irekuervo/c2/Imagenes finales/Mati kpo forever on the moon/corriente drain.png

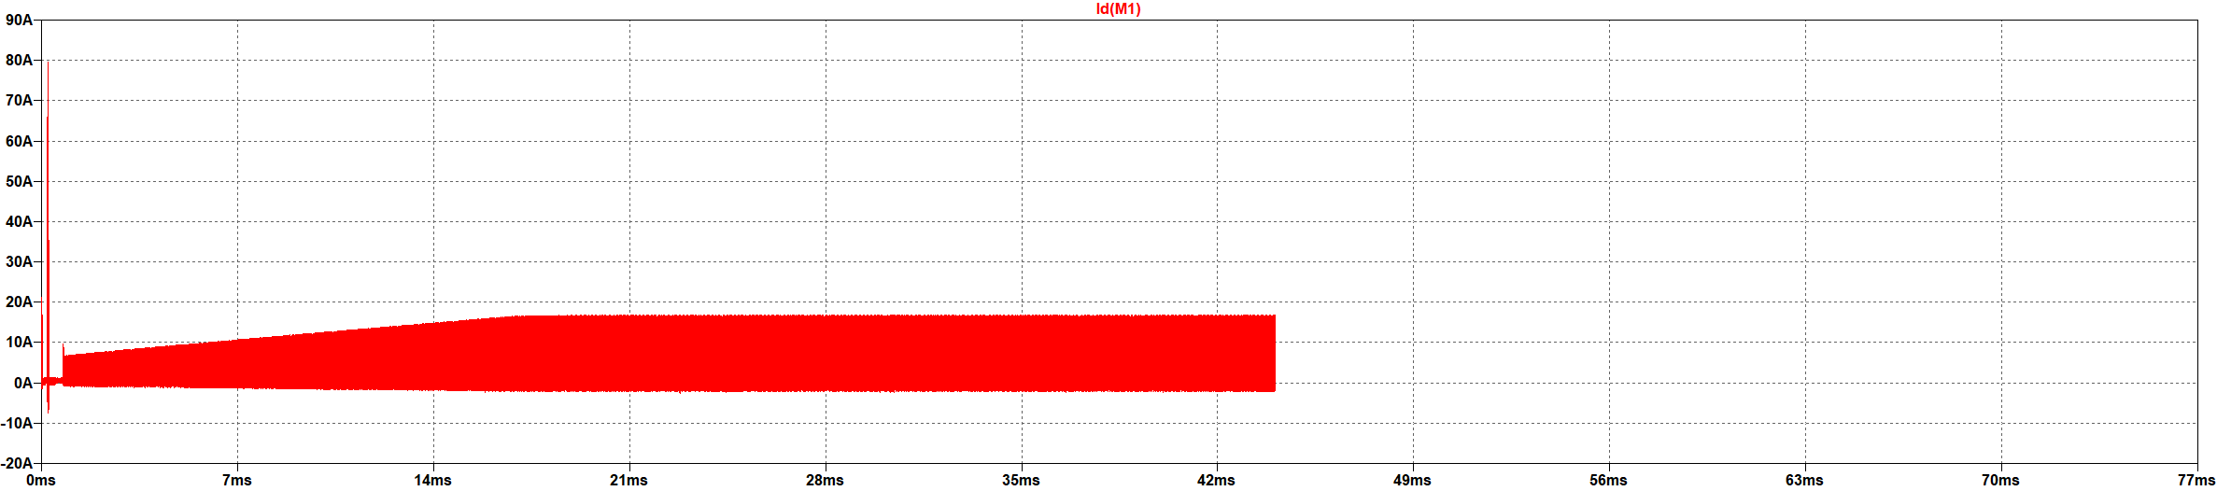
Imagenes finales/Mati kpo forever on the moon/corriente drain.png
