irekuervo/c2/Imagenes finales/Mati kpo forever on the moon/corriente y tension de drain.png

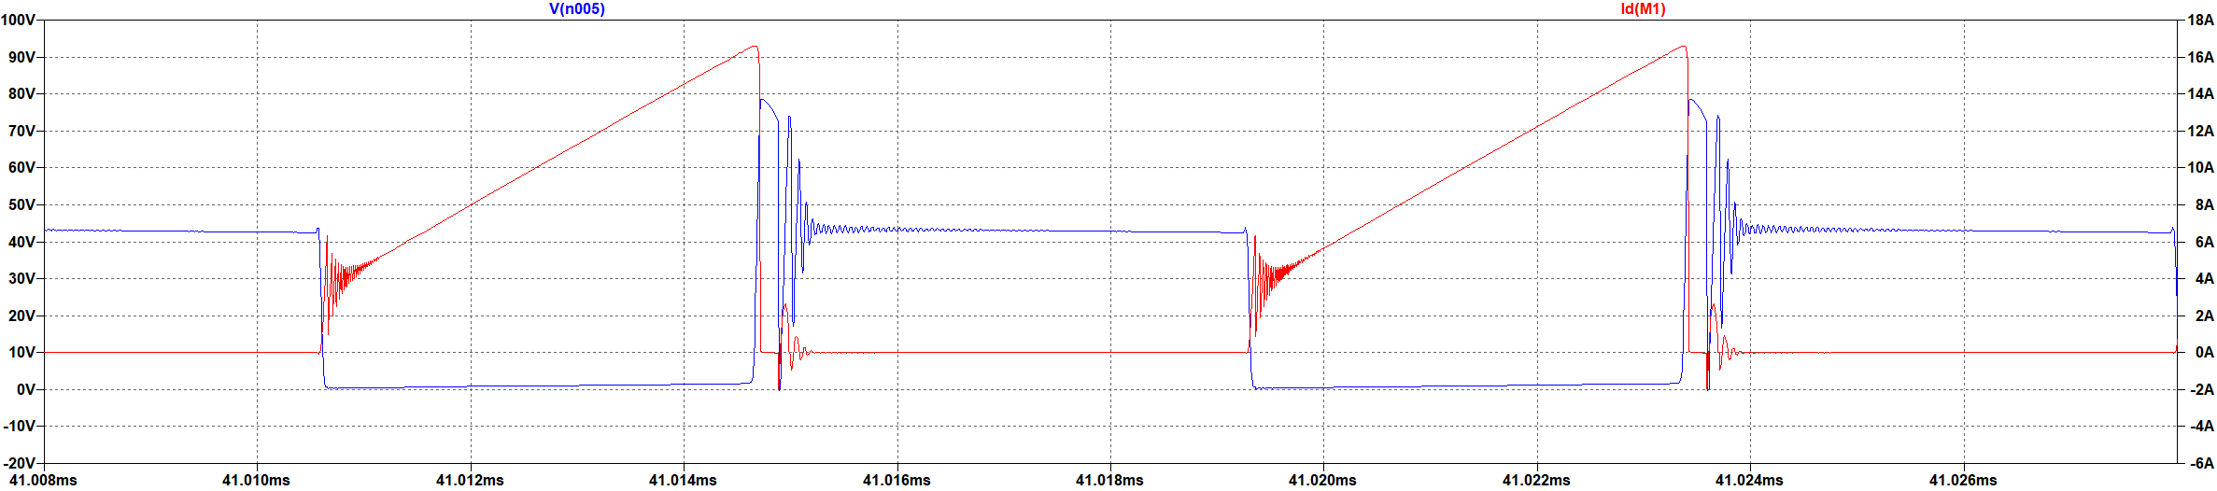
Imagenes finales/Mati kpo forever on the moon/corriente y tension de drain.png
