irekuervo/c2/Imagenes finales/Mati kpo forever on the moon/fuente con driver.png

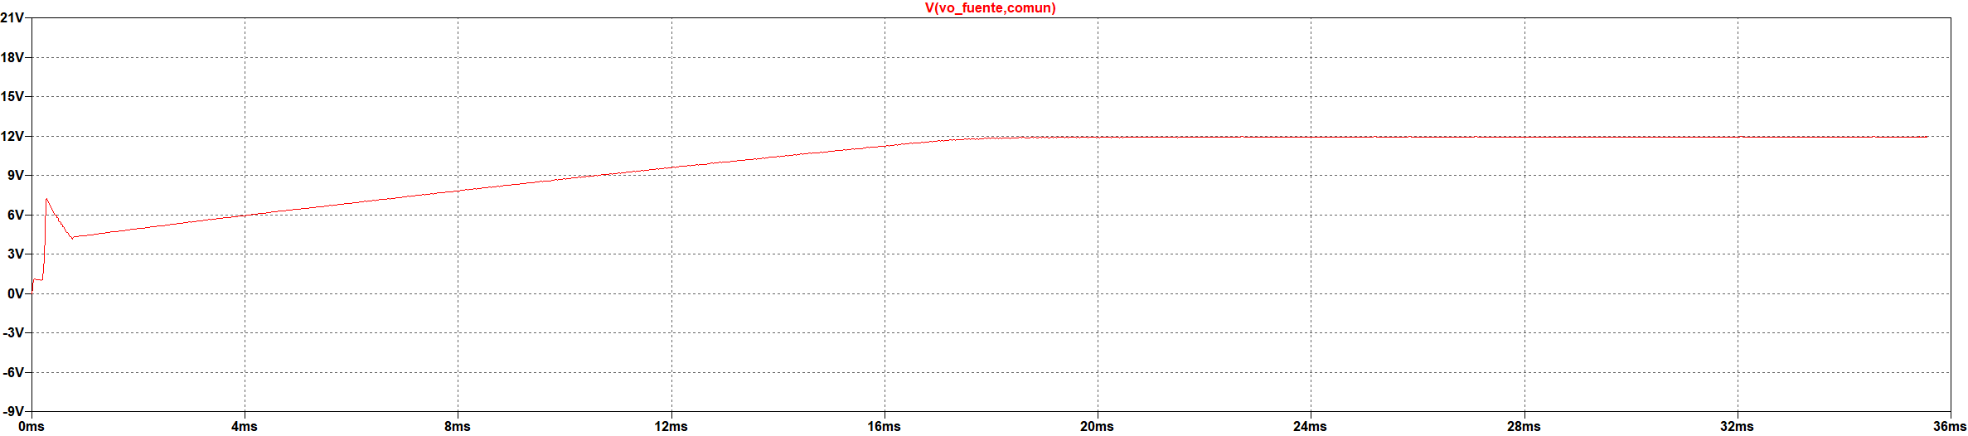
Imagenes finales/Mati kpo forever on the moon/fuente con driver.png
