irekuervo/c2/Imagenes finales/Mati kpo forever on the moon/fuente y control.png

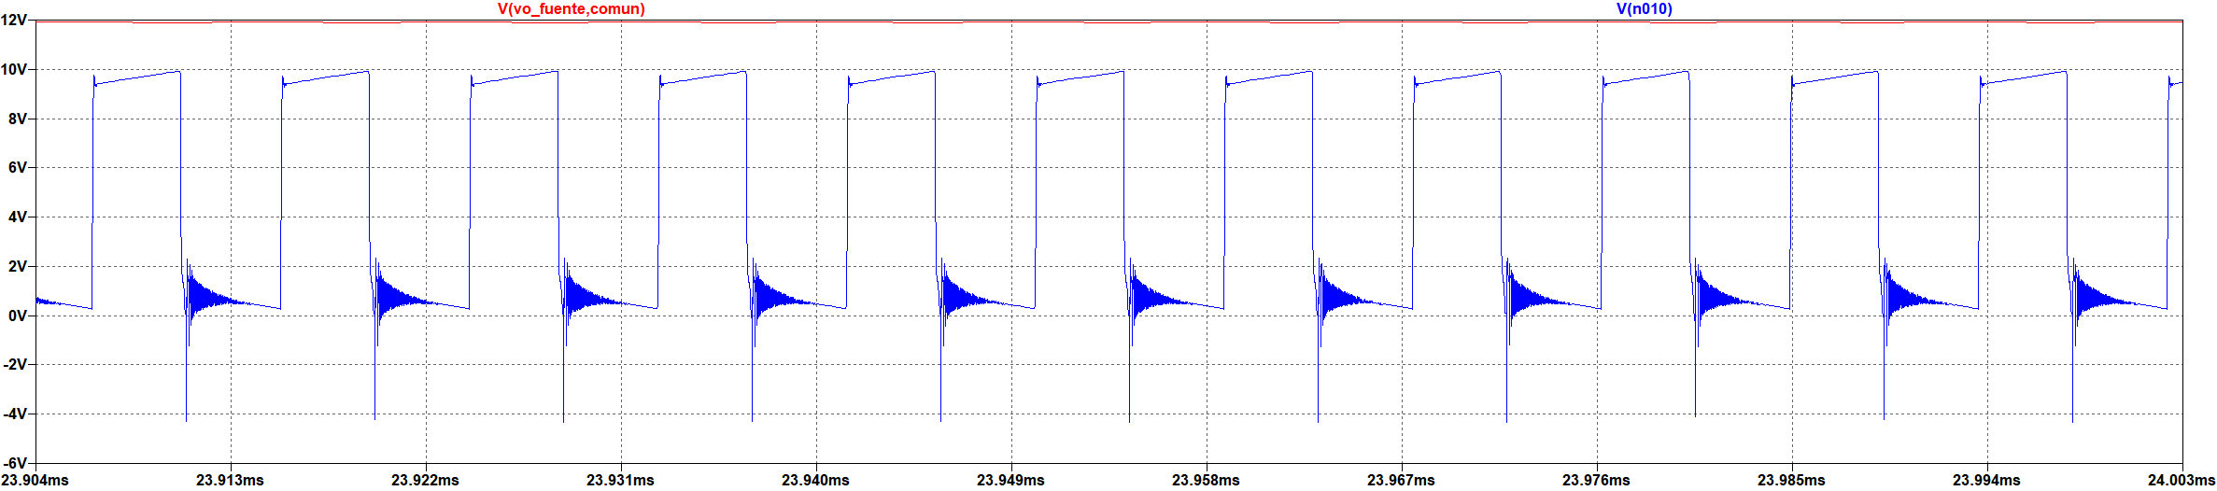
Imagenes finales/Mati kpo forever on the moon/fuente y control.png
