irekuervo/c2/Imagenes finales/Mati kpo forever on the moon/gate vs drain.png

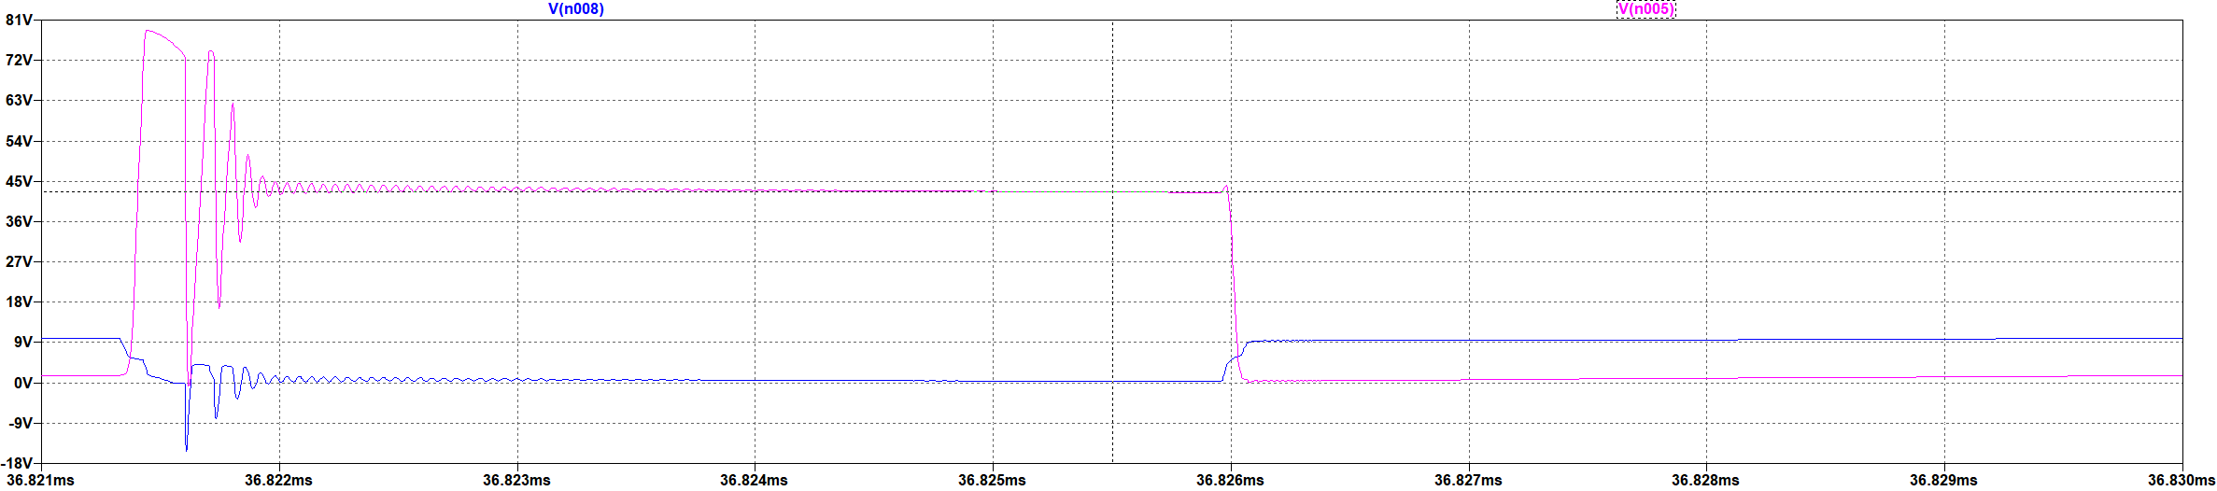
Imagenes finales/Mati kpo forever on the moon/gate vs drain.png
