irekuervo/c2/Imagenes finales/Mati kpo forever on the moon/potencia 11W.PNG

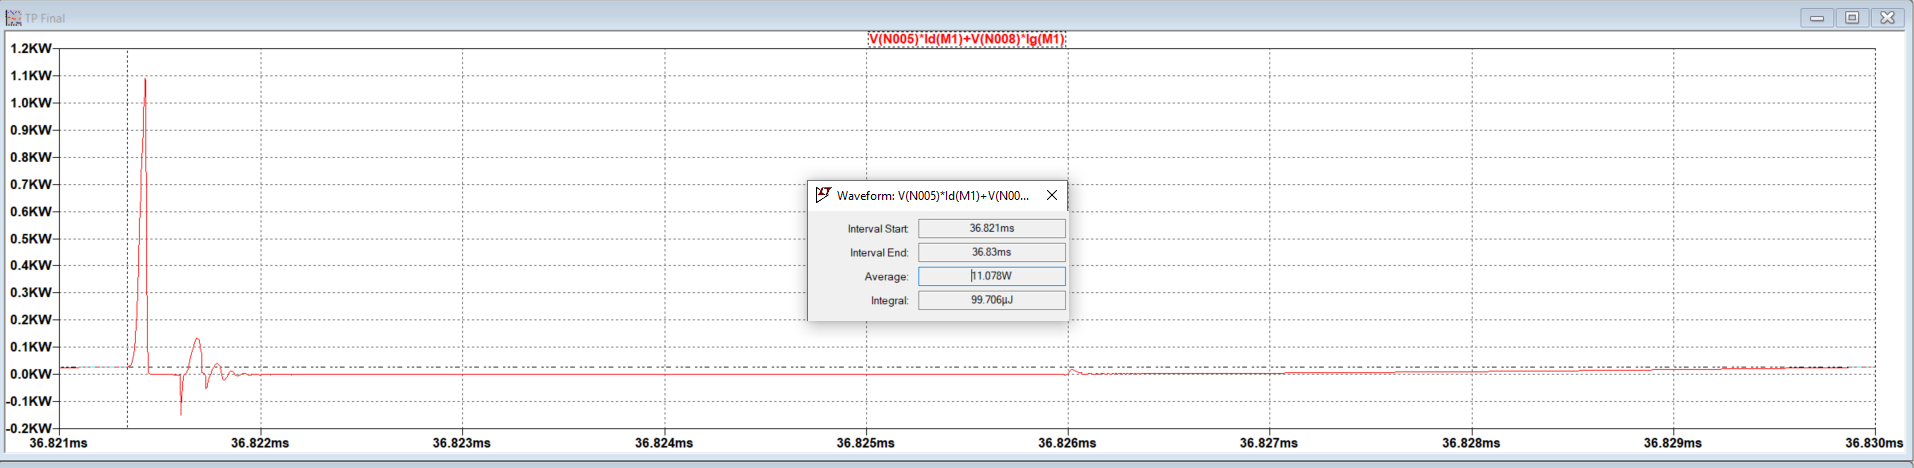
Imagenes finales/Mati kpo forever on the moon/potencia 11W.PNG
