irekuervo/c2/Imagenes finales/Mati kpo forever on the moon/tension de drain.png

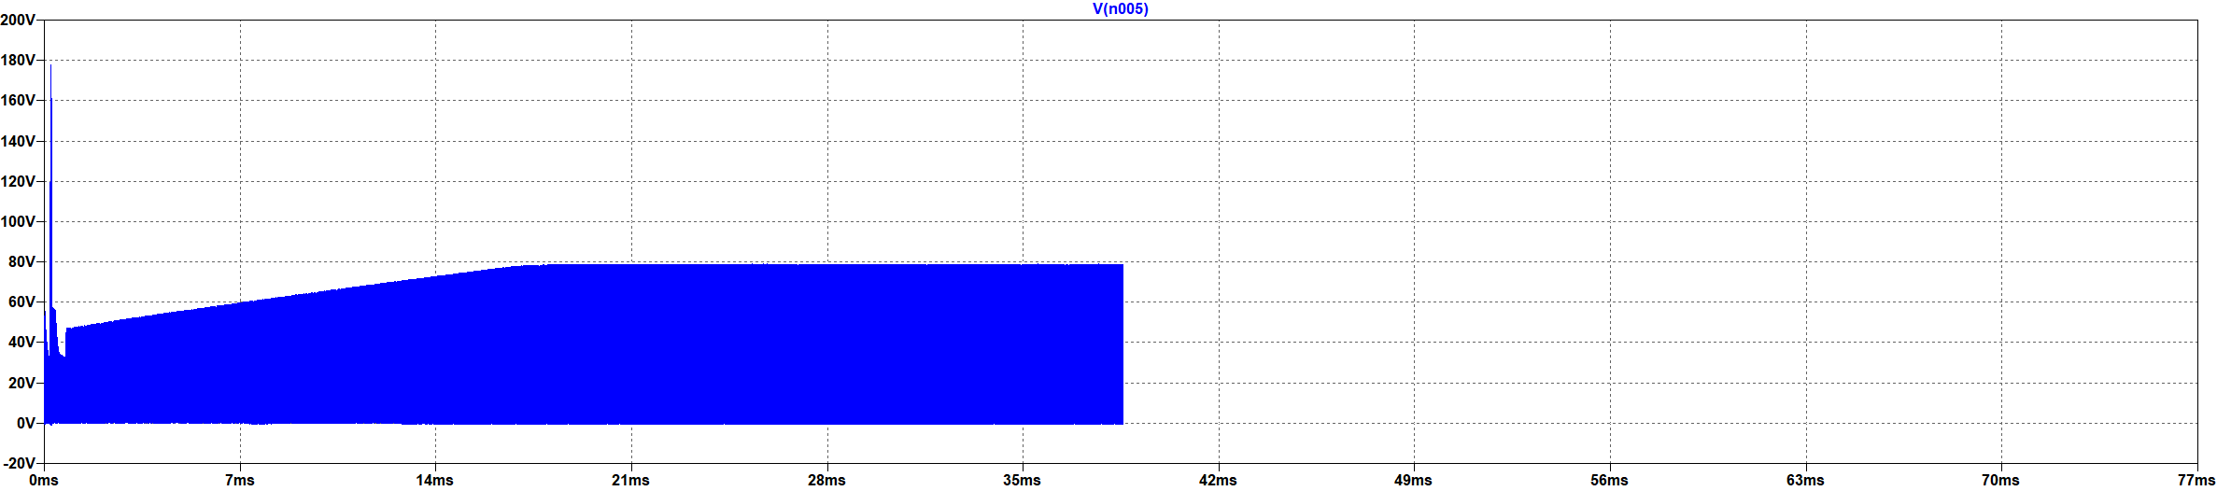
Imagenes finales/Mati kpo forever on the moon/tension de drain.png
