irekuervo/c2/Ejemplos/Banco prueba octocoupler.asc

5k: res; 4k
C1: cap; 1n
C2: cap; 1µ
C3: cap; 22n
R1: res; 10k
R2: res; 51k
R3: res; 510
R4: res; 51k
R5: res; 51k
R6: res; 150
R7: res; 10k
R8: res; 850
R9: res; 34k
R10: res; 1m
R11: res; 100Meg
U1: tl494
U2: TL431
U3: PC817A
V1: voltage; 15
V2: voltage; SINE(0 0.5 10k)
Vcc1: voltage; 15
Vcc3: voltage; 12
Named nets: 0, Vcc, Rt, Ct, Vref, Vo2, Vin, prueba, referencia, comun
.tran 0 2m 0.4m 1u
