irekuervo/c2/Ejemplos/Banco prueba tl494.asc

C1: cap; 1n
R1: res; 10k
R2: res; 51k
R3: res; 510
R4: res; 150
R8: res; 51k
R9: res; 51k
U1: tl494
V1: voltage; 2.5
V2: voltage; SINE(0 0.05 10k)
Vcc1: voltage; 40
Named nets: 0, Vcc, Rt, Ct, Vref, Vin, Vo
.tran 0 10m 0 0.1u uic
