irekuervo/c2/Spice/bancos de prueba/Banco de prueba Fuente PARASITA.asc

C1: cap; 266n
C2: cap; 240µ
D1: diode; 1N4148
D2: diode; RFU10TF6S
L1: ind2; 6.94µ
L2: ind2; 3.62µ
L3: ind2; 63n
M1: nmos; IRF530
R1: res; 376
R2: res; 1.7
R3: res; 100Meg
V1: voltage; 24
V2: voltage; PULSE(0 10 0 1n 1n 5u 10u)
Named nets: 0, control
.tran 0 2m 0 10u
K L1 L2 0.98
