irekuervo/c2/Spice/bancos de prueba/Banco de prueba Fuente.asc

C1: cap; 266n
C2: cap; 240µ
D1: diode; 1N4148
D2: diode; RFU10TF6S
L1: ind2; 6.94µ
L2: ind2; 3.62µ
L3: ind2; 63nH
M1: nmos; IRF530
Q1: pnp; 2N3906
Q2: npn; 2N3904
R1: res; 376
R2: res; 1.7
R3: res; 100Meg
V1: voltage; 24
V2: voltage; 10
V4: voltage; PULSE(0 10 0 1n 1n 5u 10u)
Named nets: 0
.tran 0 2m 0 100n
K L1 L2 0.98
