irekuervo/c2/Spice/bancos de prueba/Banco de prueba controlador.asc

C1: cap; 1n
R1: res; 10k
R2: res; 150
R3: res; 51k
R4: res; 51k
R5: res; 5.1k
R6: res; 510
U1: tl494
V1: voltage; 10
V2: voltage; 2.5
V3: voltage; SINE(0  200m 10k)
Named nets: 0, Vref, Controller, referencia, Vin
.tran 0 4m 2m 0.1u uic
