irekuervo/c2/Spice/bancos de prueba/Opto.asc

C1: cap; 1µ
C2: cap; 22n
R1: res; 880
R2: res; 4.2k
R3: res; 10k
R4: res; 38k
R5: res; 1m
U1: PC817A
U2: TL431
V1: voltage; 21
V2: voltage; SINE(0 130m 100k); AC 130
V3: voltage; 12
Named nets: 0, Vi, Vo, 15V, vo_ref
;op 20m
.tran 2m
;ac dec 20m 10k 500k
