irekuervo/c2/Spice/TP Final.asc

C1: cap; 1µ
C2: cap; 22n
C3: cap; 266n
C4: cap; 500µ
C5: cap; 1n
C6: cap; 1m
D1: diode; 1N4148
D2: diode; RFU10TF6S
L1: ind2; 6.94µ
L2: ind2; 3.62µ
L3: ind2; 63n
M1: nmos; IRF530
Q1: pnp; 2N3906
Q2: npn; 2N3904
R1: res; 860
R2: res; 4.2k
R3: res; 10k
R4: res; 38k
R5: res; 1m
R6: res; 376
R7: res; 1.7
R8: res; 100Meg
R9: res; 10k
R10: res; 150
R11: res; 51k
R12: res; 51k
R13: res; 5.1k
R14: res; 510
R15: res; 8000
R16: res; 10
U1: PC817A
U2: TL431
U3: tl494
V3: voltage; 10
Vcc: voltage; 24
Named nets: 0, vin_controlador, vo_ref, vo_fuente, comun, Rt, Ct, Vref
K L1 L2 0.98
.tran 0 100m 0 0.5m
