irekuervo/c2/Ejemplos/Draft1.asc

C1: cap; 1n
Q1: npn
R1: res; 10k
R2: res; 1k
R3: res; 51k
R4: res; 510
R5: res; 100
R7: res; 100
R8: res; 100
U1: tl494
V1: voltage; 2.5
V2: voltage; 2.51
V3: voltage; 5
Vcc: voltage; 21
Named nets: 0, Vcc, Rt, Ct, 5v, Vo
.tran 10m uic
