irekuervo/c2/Ejemplos/tl494 erik.asc

C1: cap; 1n
M1: nmos; IRF530
R1: res; 10k
R2: res; 1k
R3: res; 51k
R4: res; 510
R5: res; 100
R6: res; 51k
R7: res; 400
R8: res; 100
R9: res; 51k
U1: tl494
V1: voltage; 2.5
V2: voltage; SINE(0 0.5 10k)
Vcc: voltage; 40
Named nets: 0, Vcc, Rt, Ct, Vo, Vref, Vin
.tran 10m uic
