irekuervo/c2/Ejemplos/Ejemplo TL494 - configuracion push pull.asc

C1: polcap; 4.7µ
C2: cap; 0.01µ
C3: cap; 15p
C4: cap; 15p
R1: res; 6.8K
R2: res; 390
R3: res; 47K
R4: res; 12K
R5: res; 68
R6: res; 68
U1: tl494
VCC: voltage; 15V
Named nets: 0, PWM1, PWM2, CT
.tran 10m uic
CONFIGURACION PUSH PULL
DTC/SOFT START
******Ejemplo******
TIEMPO MUERTO = 4.3%
TON max = 40.7%
TOFF = 59.3%
TIEMPO SOFT START = 8mS
f OSC = 10Khz
VCCmax= 40V
Corriente Max por transistor = 250mA
Corriente Max Vref = 25mA
