irekuervo/c2/PCB/pcb_flyback/pcb_flyback.kicad_pcb

## KiCad design PCB/pcb_flyback/pcb_flyback.kicad_pcb (2021-07-30)

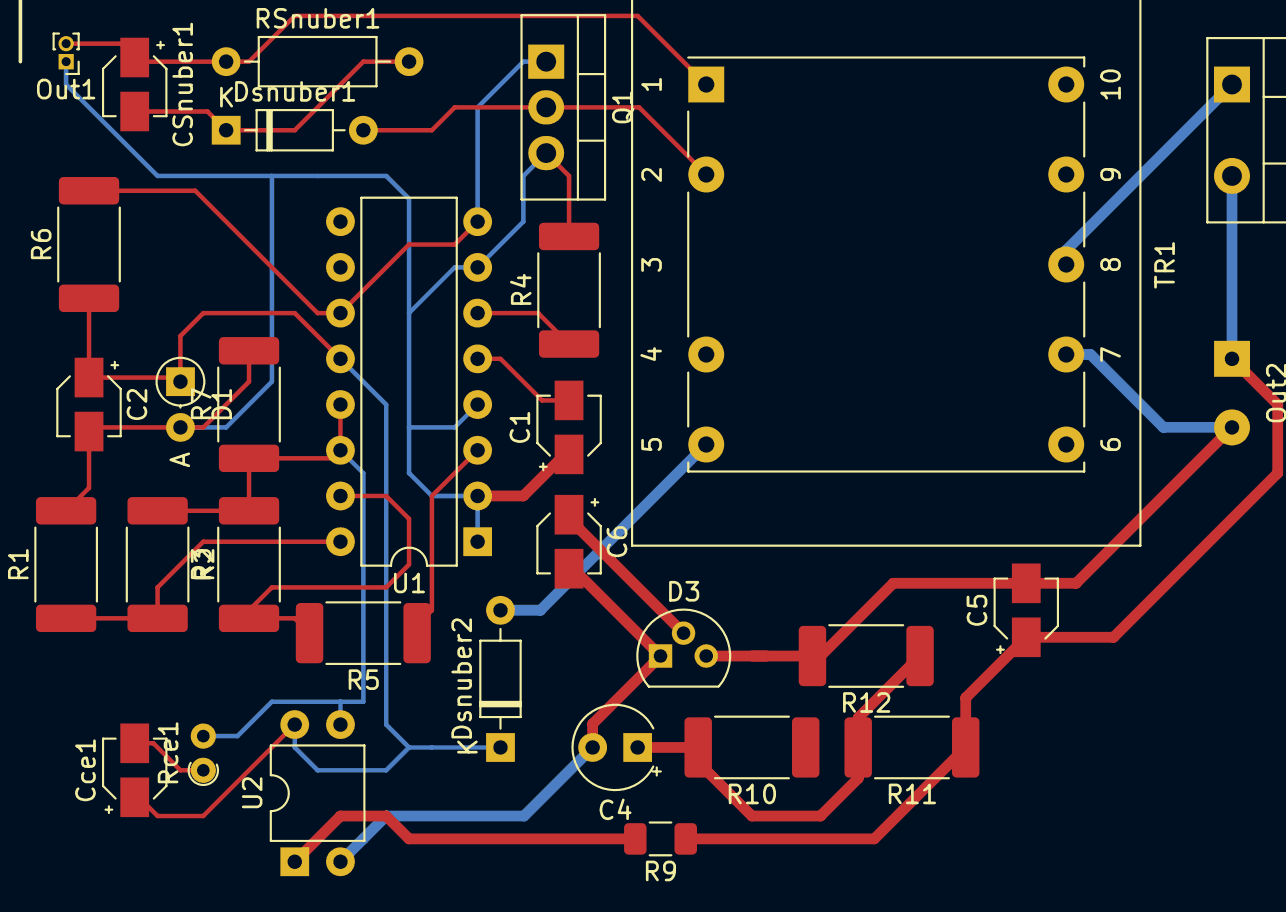
[picture p34: board pcb_flyback.kicad_pcb from above]

Board: 2 copper layers, 31 parts (0 on the bottom side), 20 nets.

Parts:
C1: 1n; CP_Elec_3x5.3
C2: 22n; CP_Elec_3x5.3
C4: 22n; CP_Radial_Tantal_D4.5mm_P2.50mm
C5: 500u; CP_Elec_3x5.3
C6: 1u; CP_Elec_3x5.3
CSnuber1: 55.2u; CP_Elec_3x5.3
Cce1: 1m; CP_Elec_3x5.3
D1: 15V; D_DO-35_SOD27_P2.54mm_Vertical_AnodeUp
D2: RFU10TF6S; TO-220-2_Vertical
D3: TL431D; TO-92L
Dsnuber1, Dsnuber2: 1N4148; D_DO-35_SOD27_P7.62mm_Horizontal
Out1: Screw_Terminal_01x02; PinHeader_1x02_P1.00mm_Vertical
Out2: Screw_Terminal_01x02; SolderWirePad_1x02_P3.81mm_Drill0.8mm
Q1: IRF540N; TO-220-3_Vertical
R1, R2: 51k; R_2512_6332Metric_Pad1.52x3.35mm_HandSolder
R3: 510; R_2512_6332Metric_Pad1.52x3.35mm_HandSolder
R4, R12: 10k; R_2512_6332Metric_Pad1.52x3.35mm_HandSolder
R5: 5.1k; R_2512_6332Metric_Pad1.52x3.35mm_HandSolder
R6: 150; R_2512_6332Metric_Pad1.52x3.35mm_HandSolder
R7: 860; R_2512_6332Metric_Pad1.52x3.35mm_HandSolder
R9: 4.2k; R_1206_3216Metric
R10: 1m; R_2512_6332Metric_Pad1.52x3.35mm_HandSolder
R11: 38k; R_2512_6332Metric_Pad1.52x3.35mm_HandSolder
RSnuber1: 4k; R_Axial_DIN0207_L6.3mm_D2.5mm_P10.16mm_Horizontal
Rce1: 8k; R_Axial_DIN0204_L3.6mm_D1.6mm_P1.90mm_Vertical
TR1: TRANSF6; Transformer_Breve_TEZ-28x33
U1: TL494; DIP-16_W7.62mm
U2: PC817; DIP-4_W7.62mm

Connections:
GND: C1.1, C2.2, D1.2, Out1.1, Q1.3, R1.2, R4.2, R7.2, TR1.4, U1.1, U1.2, U1.4, U1.7
unnamed: C1.2, U1.5
unnamed: C2.1, Cce1.1, D1.1, Dsnuber2.1, R6.1, U1.12, U2.4
unnamed: C4.1, R10.2, R11.2, R12.1
unnamed: C4.2, C6.2, D3.1, U2.2
unnamed: C5.1, D2.2, Out2.1, R9.1, R11.1
unnamed: C5.2, C6.1, D3.2, D3.3, Out2.2, R12.2, TR1.7
unnamed: CSnuber1.1, Out1.2, RSnuber1.1, TR1.1
unnamed: CSnuber1.2, Dsnuber1.1, RSnuber1.2
unnamed: Cce1.2, Rce1.1
unnamed: D2.1, TR1.8
unnamed: Dsnuber1.2, Q1.2, TR1.2
unnamed: Dsnuber2.2, TR1.3
unnamed: Q1.1, R6.2, U1.8, U1.11
unnamed: R1.1, R2.2, U1.16
unnamed: R2.1, R3.2, R7.1, Rce1.2, U1.13, U1.14, U2.3
unnamed: R3.1, R5.2, U1.15
unnamed: R4.1, U1.6
unnamed: R5.1, U1.3
unnamed: R9.2, U2.1
