irekuervo/c2/(commit log)

2021-07-09 Circuito con modelo de Spice TL494 y Nota de aplicacion de TI para flyback converter
2021-07-10 Circuito previo mail a Fede
2021-07-15 El Tp final queda dentro de la carpeta SPICE y agrego la application note del snuber AN4147
2021-07-17 Nota de aplicacion. Diseño de una fuente de switching con TL494
2021-07-22 Agregamos octocoupler (todavia no esta andando del todo)
    Empezamos PCB
    [pcb_flyback.kicad_pcb, pcb_flyback.sch]
2021-07-25 1 Version PCB terminada (Se puede mejorar)
    [pcb_flyback.kicad_pcb, pcb_flyback.sch]
2021-07-25 agrego TL431 a tp y a banco de prueba de optocoupler
2021-07-25 cambio de resistencias de referencia diodo de compensacion
2021-07-26 cambios en PCB
    [pcb_flyback.kicad_pcb]
2021-07-27 Pruebas realizadas con Fede, no funciona, se cuelga el LTSpice. Ver que funcione a lazo abierto por un lado, que funcione el opto con el controlador por el otro y cerrar
2021-07-28 Agrego banco de prueba del controlador
2021-07-28 cambios en los bancos de prueba de fuente y controlador
    [pcb_flyback.kicad_pcb]
2021-07-28 Cambios PCB, faltan otros
    [pcb_flyback.kicad_pcb]
2021-07-28 Cambios PCB
    [pcb_flyback.kicad_pcb, pcb_flyback.sch]
2021-07-28 Se conectó una señal de 12V, 10kHz y 20m de ripple al optocpupler.
    Se conectó el optocoupler con el controlador y la salida del controlador
    controlando el mosfet.
    Hay una señal de salida de 12.9V
    Todavia no se conectó la salida de la fuente con la entrada al opto
2021-07-30 PCB 99% listo
    [pcb_flyback.kicad_pcb, pcb_flyback.sch]
2021-07-30 PCB 99,9% listo
    [pcb_flyback.kicad_pcb]
2021-08-02 Cambios en banco de prueba del controlador
2021-08-03 cambio resistencia del snubber
2021-08-04 agrego diodo para limitar potencia
2021-08-05 agrego nuevo snubber, inductancia parasita y driver del mosfet
2021-08-06 circuito final con el snubber descalibrado
